wagiminator/ATtiny412-VoiceChanger/documentation/VoiceChanger_pic2.jpg

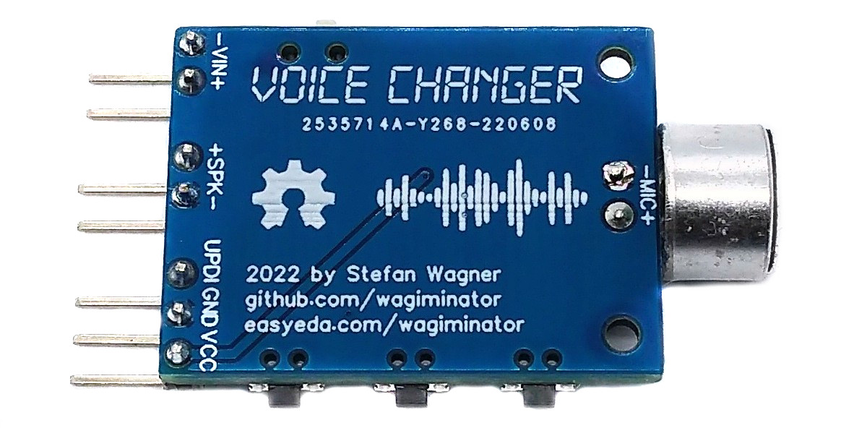
documentation/VoiceChanger_pic2.jpg
