wagiminator/ATtiny412-VoiceChanger/hardware/VoiceChanger_BOM.tsv

ID | Name | Designator | Footprint | Quantity | Manufacturer Part | Manufacturer | Supplier | Supplier Part | Price
1 | 10u | C1 | C_0603_S | 1 | CL10A106MA8NRNC | SAMSUNG | LCSC | C96446
2 | 22u | C2,C4 | C_0603_S | 2 | CC0603KRX7R9BB104 | YAGEO | LCSC | C14663 | 0.002
3 | 100n | C3,C5 | C_0603_S | 2 | CC0603KRX7R9BB104 | YAGEO | LCSC | C14663 | 0.002
4 | VIN | J1 | HEADER_2X1 | 1 |  |  | LCSC | C124375 | 0.027
5 | SPK | J2 | HEADER_2X1 | 1 |  |  | LCSC | C124375 | 0.027
6 | UPDI | J3 | 210S-3X1/2.54 | 1 | Header2.54mm 1*3P | BOOMELE | LCSC | C49257 | 0.014
7 | UP | KEY1 | SW-SMD_TS24CA | 1 | TS24CA | SHOU HAN | LCSC | C393942 | 0.023
8 | SELECT | KEY2 | SW-SMD_TS24CA | 1 | TS24CA | SHOU HAN | LCSC | C393942 | 0.023
9 | DOWN | KEY3 | SW-SMD_TS24CA | 1 | TS24CA | SHOU HAN | LCSC | C393942 | 0.023
10 | PWR | LED1 | LED_0603_S | 1 | 19-217/GHC-YR1S2/3T | EVERLIGHT | LCSC | C72043 | 0.027
11 | ELECTRET | Q1 | 9.7ELECTRET | 1 | ?
12 | 10k | R1,R4,R5 | R_0603_S | 3 | 0603WAF1002T5E | UniOhm | LCSC | C25804 | 0.001
13 | 1k | R2,R6 | R_0603_S | 2 | 0603WAF1001T5E | UniOhm | LCSC | C21190 | 0.001
14 | 47k | R3 | R_0603_S | 1 | 0603WAF1002T5E | UniOhm | LCSC | C25804 | 0.001
15 | POWER | SW1 | SW-SMD_SS-1290L-GLL-1.5MM | 1 | SS-1290L-GL L=1.5mm | RI SHENG | LCSC | C695418 | 0.12
16 | LMV358IDR | U1 | SOP-8_150MIL | 1 | LMV358IDR | TI | LCSC | C63813 | 0.203
17 | ATTINY412-SSN | U2 | SOP-8_150MIL | 1 | ATTINY412-SSN | MICROCHIP(美国微芯) | LCSC | C1338223 | 0.577
