wagiminator/ATtiny412-VoiceChanger/hardware/VoiceChanger_schematic.pdf

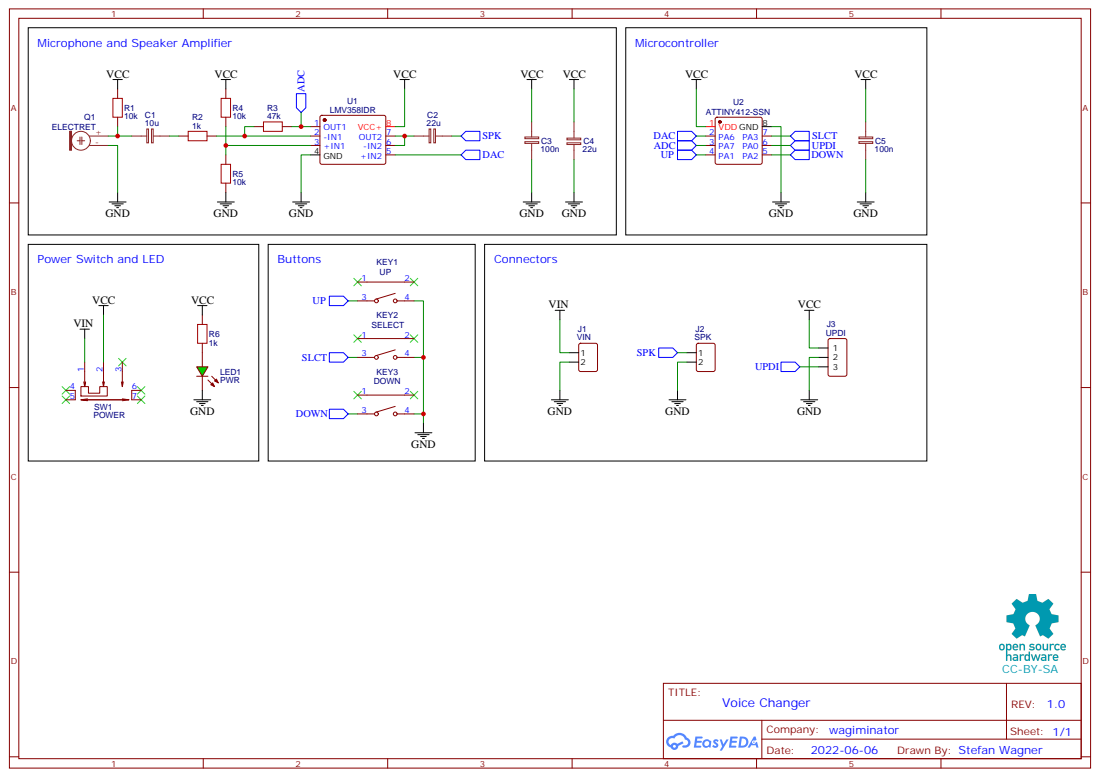
[picture p5: page 1]

Power Switch and LED

Drawn By: Stefan Wagner
